duronflo/MEMO/Hardware/Pinning_ARDUINO_MEGA 2650--M2 Interface.pdf

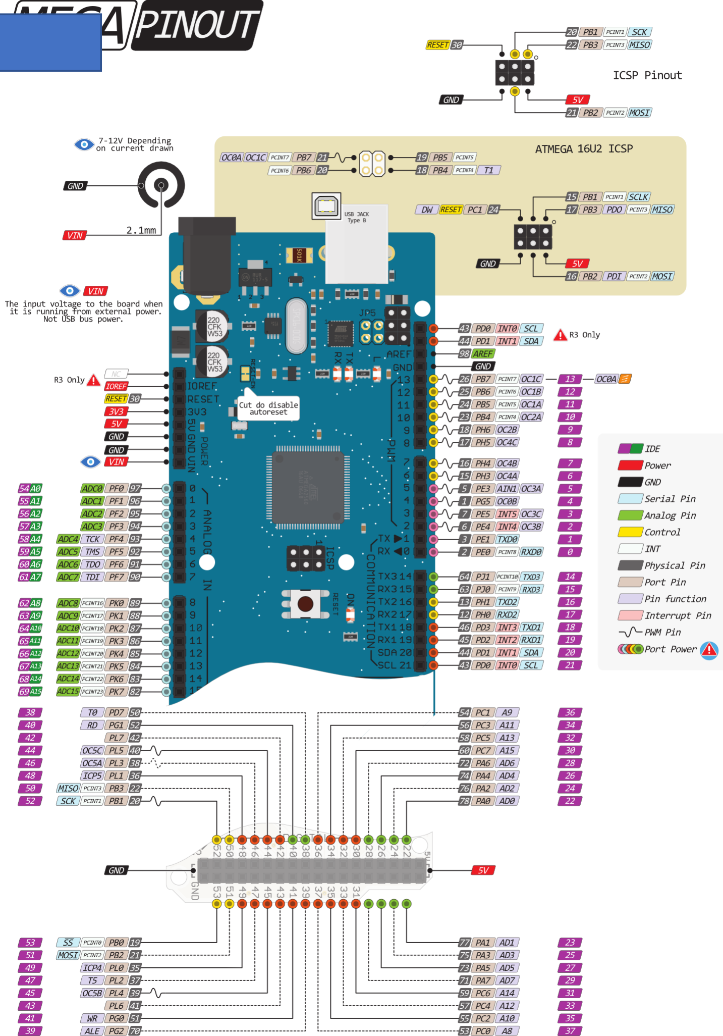
[picture p6: figure]

Arduino MEGA2560

PIN OUT BREAKOUT M2 Interface Board

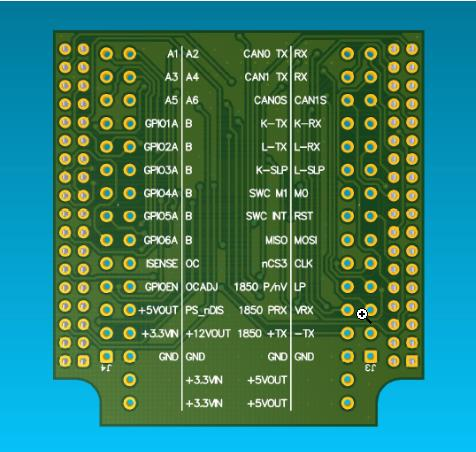
[picture p7: figure]
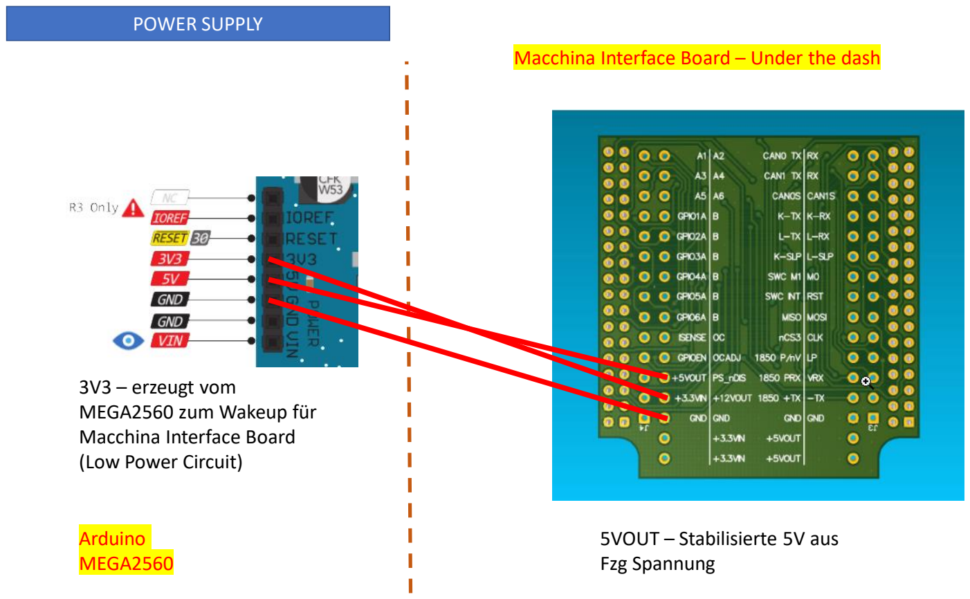
[picture p8: page 3]

Macchina Interface Board – Under the dash

POWER SUPPLY

Arduino
MEGA2560

5VOUT – Stabilisierte 5V aus Fzg Spannung

3V3 – erzeugt vom
MEGA2560 zum Wakeup für
Macchina Interface Board
(Low Power Circuit)

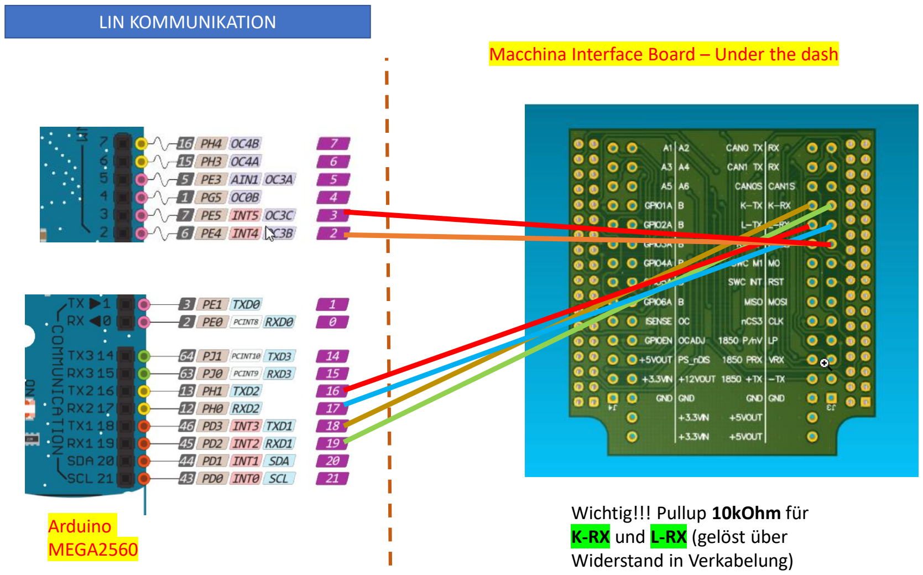
[picture p9: page 4]

Macchina Interface Board – Under the dash

LIN KOMMUNIKATION

Wichtig!!! Pullup 10kOhm für K-RX und L-RX (gelöst über Widerstand in Verkabelung)

Arduino
MEGA2560

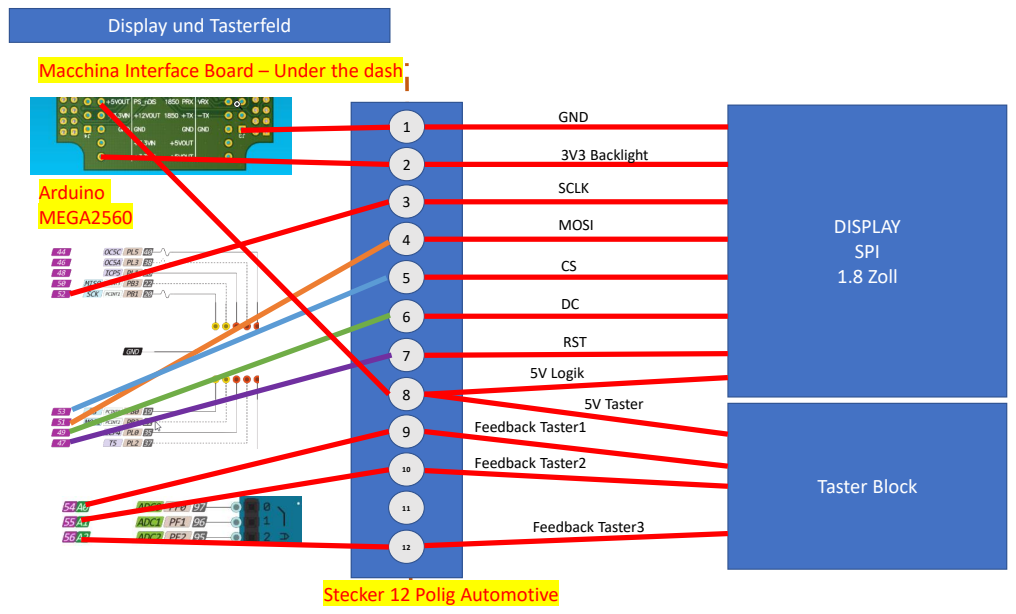
[picture p10: page 5]
Arduino MEGA2560; DISPLAY SPI 1.8 Zoll; Taster Block; GND; 3V3 Backlight; SCLK; MOSI; RST; 5V Taster; Feedback Taster3; Feedback Taster2; Feedback Taster1; 5V Logik

Display und Tasterfeld

Macchina Interface Board – Under the dash

Stecker 12 Polig Automotive

Die Widerstände sind wichtig, um von 5V auf 3.3V
herunterzusetzen…

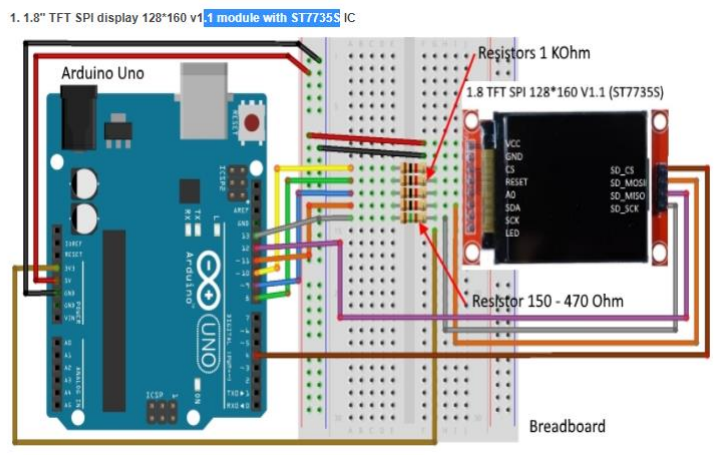
[picture p11: figure]
