duronflo/MEMO/Bilder/2020-01-01 16_53_48-Window.png

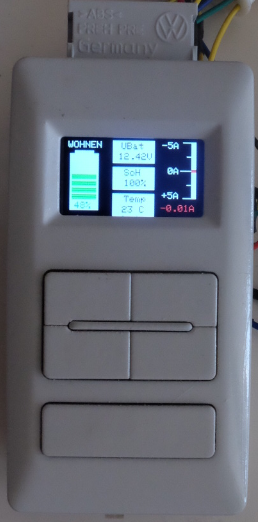
Bilder/2020-01-01 16_53_48-Window.png
