duronflo/MEMO/Bilder/2020-01-01 16_55_30-Window.png

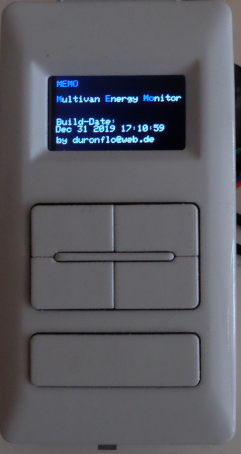
Bilder/2020-01-01 16_55_30-Window.png
