duronflo/MEMO/Bilder/2020-01-01 17_16_46-Window.png

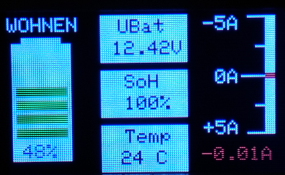
Bilder/2020-01-01 17_16_46-Window.png
