duronflo/MEMO/Bilder/IMG_20191231_003439_428.jpg

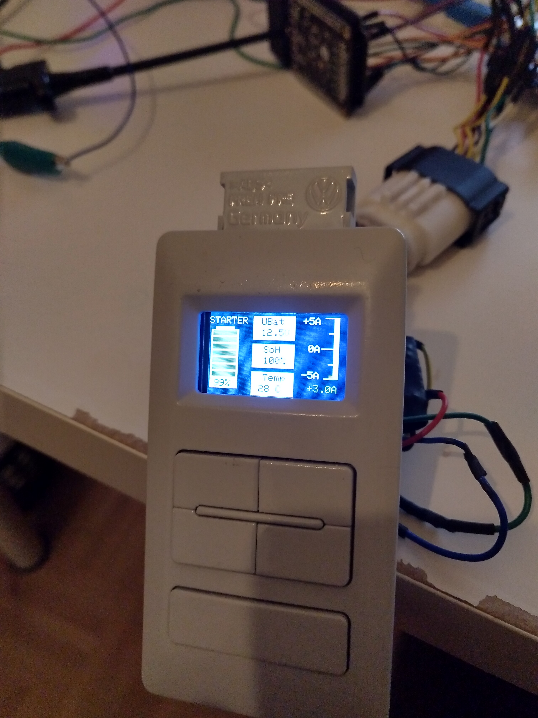
Bilder/IMG_20191231_003439_428.jpg
