duronflo/MEMO/Source/lin_stack.h

/*  Copyright (c) 2016 Macchina
 *
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
 *  LIN STACK for TJA1021
 *  v2.0
 *
 *  Short description: 
 *  Comunication stack for LIN and TJA1021 LIN transceiver. 
 *  Can be modified for any Arduino board with UART available and any LIN slave.
 *  
 *  Author: Blaž Pongrac B.S., RoboSap, Institute of Technology, Ptuj (www.robosap-institut.eu)
 *  
 *  Arduino IDE 1.6.9
 *  RoboSap, Institute of Technology, September 2016
*/ 

#include <Arduino.h>

/*
	Please, read Getting Started Guide firts.
*/

// Pin configuration, please change this according to your MEGA Board
#define LIN_CH1_TX_PIN 18
#define LIN_CH2_TX_PIN 16

#define LIN_CH1_RX_PIN 19
#define LIN_CH2_RX_PIN 17

#define LIN_CH1_SLP_PIN 2
#define LIN_CH2_SLP_PIN 3


// Only visible as long as the checksum of data is correct, if not display  DEBUG_LIN_PRINT_RAW_PURE_RX_MSGS
// D0 | ... | Dn
#define DEBUG_LIN_PRINT_RAW_DATA_RX_MSGS 0

// RAW RX Message has following style:
// | 0x55 | (pID & Partity) Byte | D0 | ... | Dn| Checksum (Classic)
#define DEBUG_LIN_PRINT_RAW_PURE_RX_MSGS 0



class lin_stack
{
	public:
		// Constructors
		lin_stack(byte Ch); // Constructor for Master Node
		lin_stack(byte Ch, byte ident); // Constructor for Slave Node
		
		// Methods
		
		// Writing data to bus
		int write(byte add, byte data[], byte data_size); // write whole package
		int writeRequest(byte add); // Write header only
		int writeResponse(byte data[], byte data_size); // Write response only
		int writeStream(byte data[], byte data_size); // Writing user data to LIN bus  
    // Read data from bus
    int readResponseByID(byte messageID, byte* recvBuffer, byte bufferLength); // Get Values from corresponding id -- readResponseByID(0x2C, recv_buffer, 6);
		int read(byte data[], byte data_size); // read data from LIN bus, checksum and ident validation
		int readStream(byte data[],byte data_size); // read data from LIN bus
		
		int busWakeUp(); // send wakeup frame for waking up all bus participants
	
	// Private methods and variables
	private:
		const unsigned long baudRate = 19200; // 10417 is best for LIN Interface, most device should work
		const unsigned int period = 52; // in microseconds, 1s/10417
		byte ch = 0; // which channel should be used
		byte identByte; // user defined Identification Byte
		int sleep(byte sleep_state); // method for controlling transceiver modes (0 - sleep, 1 - normal)
		int sleep_config(byte serial_No); // configuration of sleep pins
		int serial_pause(int no_bits); // for generating Synch Break
		boolean validateParity(byte ident); // for validating Identification Byte, can be modified for validating parity
		boolean validateClassicChecksum(byte data[], byte data_size); // for validating Classic Checksum Byte
    boolean validateEnhancedChecksum(byte data[], byte data_size); // for validating Enhanced Checksum Byte
		byte calcIdentParity(byte ident); // calculates ident id parity
    void printLinRxDataBuffer(byte channel, byte * data, byte dataLength); // debugging function for outputung RX Data buffers ...
		
};
